Seeed-Studio/beaglebone-getting-started/Docs/images/bbgw-leds.jpg

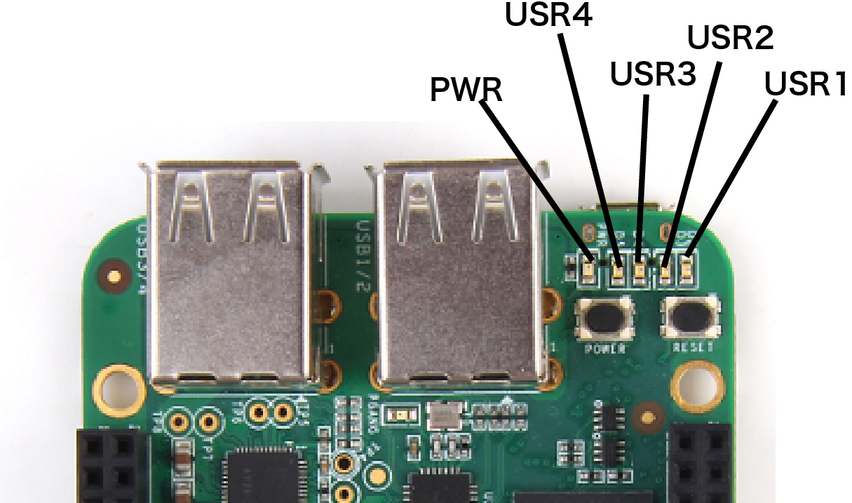
Docs/images/bbgw-leds.jpg
