Seeed-Studio/beaglebone-getting-started/Docs/images/BBGW-on-USB.png

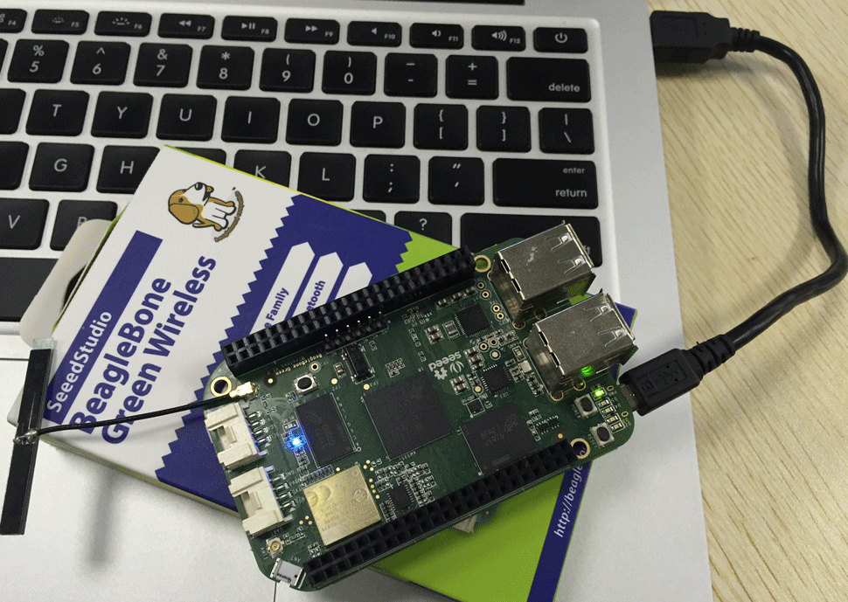
Docs/images/BBGW-on-USB.png
