Seeed-Studio/beaglebone-getting-started/Docs/Hardware/BeagleBone_Green_Wireless_V1.0_BOM.xlsx

Part No. | Part Name | Part Description | Reference | Quantity | Unit
301010000 | SMD RES 0R-5%-1/16W;0402 | YAGEO;RC0402JR-070RL | R5,R6,R7,R8,R19,R20,R27,R29,R30,R46,R47,R48,R49,R50,R51,R159,R160,R161,R162,R224,R231,R232,R234,R235 | 24 | PCS
301010010 | SMD RES 4.7K-5%-1/16W;0402 | YAGEO;RC0402JR-074K7L | R23,R24,R25,R26,R71,R72,R73,R74,R163,R164 | 10 | PCS
301010034 | SMD RES 33R-5%-1/16W;0402 | YAGEO;RC0402JR-0733RL | R18,R45,R167,R176,R177,R178,R179,R180,R181,R182,R183,R184,R185,R186,R187,R188,R198,R199,R200,R203,R204,R205,R206,R207,R208,R236,R237,R238,R239 | 29 | PCS
301010043 | SMD RES 1M-1%-1/16W;0402 | YAGEO;RC0402FR-071ML | R17 | 1 | PCS
301010047 | SMD RES 10K-1%-1/16W;0402 | YAGEO;RC0402FR-0710KL | R14,R54,R96,R98,R100,R101,R102,R103,R104,R105,R106,R107,R108,R109,R110,R111,R150,R151,R152,R153,R154,R155,R156,R157,R191,R192,R193,R194,R196,R221,R223,R225,R227 | 33 | PCS
301010054 | SMD RES 47K-1%-1/16W;0402 | YAGEO;RC0402FR-0747KL | R228 | 1 | PCS
301010203 | SMD RES 0R-1%-1/10W;0603 | YAGEO;AC0603FR-070RL | R168 | 1 | PCS
301010264 | SMD RES 0.1R-5%-1/8W;0805 | YAGEO;RL0805JR-070R1L | FB8 | 1 | PCS
301010442 | SMD RES 100R-1%-1/16W;0402 | YAGEO;RC0402FR-07100RL | R75 | 1 | PCS
301010456 | SMD RES 100K-1%-1/16W;0402 | YAGEO;RC0402FR-07100KL | R1,R56,R65,R66,R67,R68,R76,R77,R78,R79,R80,R82,R83,R84,R85,R86,R87,R88,R89,R94,R95,R165,R189,R190,R220 | 25 | PCS
301010489 | SMD RES;49.9R-1%-1/10W-0402 | Panasonic;ERJ-2RKF49R9X | R22 | 1 | PCS
301010494 | SMD RES;240R-1%-0402 | Panasonic;667-ERJ-2RKF2400X | R99 | 1 | PCS
301010518 | SMD RES 120K-1%-1/16W;0402 | RC0402FR-07120KL | R215 | 1 | PCS
301010567 | SMD RES 1.5K-1%-1/16W;0402 | Yageo;RC0402FR-071K5L | R3,R4,R12,R97,R197 | 5 | PCS
301010738 | SMD RES 15K-1/16W-1%;0402 |  | R222 | 1 | PCS
301010829 | SMD RES 680R-1%-1/16W;0402 | Yageo;RC0402FR-07680RL | R218,R219,R229,R230 | 4 | PCS
301011069 | SMD RES 240K-1/16W-1%;0402 | YAGEO;RC0402FR-07240KL | R214,R216 | 2 | PCS
301011070 | SMD RES 52.3K-1/16W-1%;0402 | YAGEO;RC0402FR-0752K3L | R217 | 1 | PCS
302010004 | SMD CAP Ceramic 100nF-16V-10%-X7R;0402 | YAGEO;CC0402KRX7R7BB104 | C3,C28,C29,C30,C31,C33,C36,C37,C38,C41,C42,C43,C44,C45,C46,C47,C48,C49,C50,C51,C52,C53,C54,C56,C57,C58,C59,C60,C61,C63,C64,C65,C66,C67,C68,C69,C70,C71,C72,C73,C74,C75,C76,C78,C79,C80,C81,C82,C83,C84,C85,C86,C87,C88,C92,C93,C94,C97,C98,C99,C100,C101,C102,C103,C105,C107,C108,C109,C110,C111,C112,C113,C114,C115,C116,C117,C119,C120,C121,C124,C127,C128,C129,C130,C152,C154,C155,C158,C159,C167,C173,C174,C175,C176,C181,C182,C185,C186,C187,C189,C191,C193,C195 | 103 | PCS
302010005 | SMD CAP Ceramic 1nF-50V-10%-X7R;0402 | YAGEO;CC0402KRX7R9BB102 | C32,C123 | 2 | PCS
302010012 | SMD CAP Ceramic 100pF-50V-5%-NPO;0402 | YAGEO;CC0402JRNPO9BN101 | C202,C203,C204,C205 | 4 | PCS
302010016 | SMD CAP Ceramic 18pF-50V-5%-NPO;0402 | YAGEO;CC0402JRNPO9BN180 | C21,C22,C25,C26,C183,C184 | 6 | PCS
302010040 | SMD CAP Ceramic 1uF-10V-10%-X5R;0402 | YAGEO;CC0402KRX5R6BB105 | C89,C90,C91,C104,C106,C199 | 6 | PCS
302010047 | SMD CAP Ceramic 10pF-50V-2%-NPO;0402 | Murata;GRM1555C1H100GA01D | C171,C172 | 2 | PCS
302010158 | SMD CAP Ceramic 10uF-10V-(-20%～+80%)-Y5V;0805 | YAGEO;CC0805ZKY5V6BB106 | C1,C2,C4,C7,C8,C9,C10,C11,C12,C13,C14,C15,C39,C40,C55,C62,C77,C95,C96,C118,C122,C126,C153,C168,C169,C170,C177,C180,C188,C197 | 30 | PCS
302010171 | SMD CAP Ceramic 22uF-6.3V-20%-X5R;0805 | YAGEO;CC0805MKX5R5BB226 | C178,C179 | 2 | PCS
302010233 | SMD CAP Ceramic 2.2uF-6.3V-20%-X5R;0402 | YAGEO;CC0402MRX5R5BB225 | C16,C18,C125,C24 | 4 | PCS
302010742 | SMD CAP Ceramic 100uF-6.3V-20%-X5R;1206 | YAGEO;CC1206MKX5R5BB107 | C190,C192,C194,C196,C198 | 5 | PCS
303010128 | SMD Inductor 2.2uH-20%-1.3A;2P-1008 | Murata;LQM2HPN2R2MG0L | L1,L2,L3 | 3 | PCS
303010172 | SMD Innductor 0.47uH-20%;L2.0*W1.6*H1.0mm | Sunlord;WPN201610MR47MT | L11 | 1 | PCS
303010342 | SMD Inductor 0.33uH-20%-0.024R-3.2A;2.0*1.6*1.0mm | Murata;LQM2MPNR33MGH | L12 | 1 | PCS
303010524 | SMD Inductor 5.6nH-0.3nH-300mA;0402 | Murata;LQG15HS5N6S02D | C200 | 1 | PCS
303030024 | SMD Ferrite Bead;120R-2A;0603 | BLM18PG121SN1D | L4,L13,L14,L15,L16,L17,L18,L19,L20 | 9 | PCS
303030029 | SMD Ferrite Bead;150R-800mA-0805 | Laird-Signal Integrity Products;LI0805H151R-10 | FB1,FB2,FB3 | 3 | PCS
304060074 | SMD Diode ESD 0.05pF;0402 | SURGE;ESDPSA0402V05 | D9,D10,D11,D12,D13,D14,D15,D16,D17,D18,D19,D20,D21,D22,D23,D24 | 16 | PCS
304090043 | SMD LED Clear-Green;LED-0603 | Everlight;19-217/G7C-AN1P2/3T(正贴) | D1,D6,D8 | 3 | PCS
304090045 | SMD LED Clear-Blue;0603 | Ever Light;19-217/BHC-ZL1M2RY/3T(正贴) | D2,D3,D4,D5,D7 | 5 | PCS
305030000 | SMD MOSFET N-CH 50V-200mA;SOT-323-3 | Diodes Inc;BSS138W-7-F | Q3,Q4 | 2 | PCS
305050004 | SMD Transistor Array 2 NPN-50V-100mA-SOT-363 | Diodes Incorporated;DDC114YU-7-F | Q1,Q2 | 2 | PCS
306010085 | SMD Crystal;32.768KHz-12.5pF-20PPM-50K-8*3.8*2.5mm;SOJ-4 | ABS25-32.768KHZ-T | Y1 | 1 | PCS
306010108 | SMD Crystal;24MHz-18pF-30ppm-2P-5*3.2*1.35 | TXC CORPORATION;7A-24.000MAAJ-T | Y2 | 1 | PCS
306010127 | SMD Crystal 12MHz-6pF-30ppm-150R;4P-L2.5*W2.0mm | Epson;FA-20H 12MHz | Y5 | 1 | PCS
306020013 | SMD Oscillator;24.576MHz-CMOS-4P-2.5*2*0.9mm | Abracon Corporation;ASDMB-24.576MHZ-LC-T | Y4 | 1 | PCS
306020041 | SMD Oscillator 32.768kHz;4P-L3.2*W2.5*H1.0mm | TXC;7XZ-32.768KHz | OSC1 | 1 | PCS
310010099 | SMD IC MCU;NFBGA-324（15x15） | TI;AM3358BZCZ100 | U5 | 1 | PCS
310030161 | SMD IC PMIC;DFN(2*2)-8 | ETA;ETA3410D2I-T | U19,U20 | 2 | PCS
310030209 | SMD IC PMIC;VQFN-48 | TI;TPS65217CRSLR | U2 | 1 | PCS
310050077 | SMD IC Logic;SC-70-5 | TI;SN74LVC1G06DCKR | U3 | 1 | PCS
310050078 | SMD IC Logic;US8(8-VFSOP | TI;SN74LVC2G241DCUR | U15 | 1 | PCS
310050079 | SMD IC Logic;SC-70-5 | TI;SN74LVC1G07DCKR | U16 | 1 | PCS
310050187 | SMD IC Logic;VQFN-20 | TI;TXS0108ERGYR | U21,U22 | 2 | PCS
310090051 | SMD IC Memory;SOT-23-5 | Microchip;24LC32AT-I/OT | U7 | 1 | PCS
310090304 | SMD IC Memory;TFBGA-96（8x14) | Micron;MT41K256M16TW-107:P | U12 | 1 | PCS
310090305 | SMD IC Memory;VFBGA-153 | Micron;MTFC4GACAJCN-1M WT | U13 | 1 | PCS
310990024 | SMD Precision Load Switch with Adjustable Curren IC;DFN22-6 | ETA;ETA6020D2G-T/U | U24 | 1 | PCS
310990129 | SMD USB 2.0 MTT Hub Controller;QFN-28 | Genesys Logic;GL852G-OHG | U23 | 1 | PCS
311020045 | SMD Button Top;Black-4P-L4.7*W3.5*H2.5 | 东奥;DHT-4325A | S1,S2,S3 | 3 | PCS
317990079 | SMD Combo Module;100P-13.3*13.4*2mm | JORJIN;WG7835-V0 | U18 | 1 | PCS
318010123 | SMD Built-in Antenna 2.4GHz;3P-5.2*3.7*0.7mm | Inpad;ACA-5036-A2-CC-S | ANT1 | 1 | PCS
319011441 | PCB;BeagleBone_Green_Wireless_V1.0-哑光绿油白字-6层 | 化学沉金-121.4*174.75*1.6mm-FR4;钢网;404010698 |  | 1 | PCS
320010000 | SMD Micro USB-B-without POST-W/P;5+4-0.65-L7.4*W5.0*H2.35mm | 山旗 | P4 | 1 | PCS
320020078 | DIP Black Male Header VERT;1*6P-2.54-2.54-11.6/3.0mm | 宇熙 | J1 | 1 | PCS
320030146 | DIP Black Female Header;2*23P-2.54*8.5-3.15mm | 宇熙 | P8,P9 | 2 | PCS
320090010 | SMD Micro SD Card Holder;8P-13.9*15mm | ALPS;SCHA5B0200 | P10 | 1 | PCS
320110032 | SMD Grove;4P-2.0-90D | 2.0-4P卧贴带锁座子 | J4,J5 | 2 | PCS
320110048 | SMD Female;U-FL Connector | I-PEX; | J6,J7 | 2 | PCS
320110409 | DIP USB FEMAL TYPE A;8P-2.0-90D;双层 | 商旗;ST-USB-201C | J8,J9 | 2 | PCS
327130913 | BeagleBoneGreen Wireless_流水号二维码贴纸 | 铜版不干胶贴纸-8*40mm |  | 1 | PCS
