Seeed-Studio/beaglebone-getting-started/Docs/Hardware/BeagleBone_Green_Wireless_V1.0_SCH&PCB/BeagleBone_Green_Wireless_V1.0_SCH.pdf

1
3

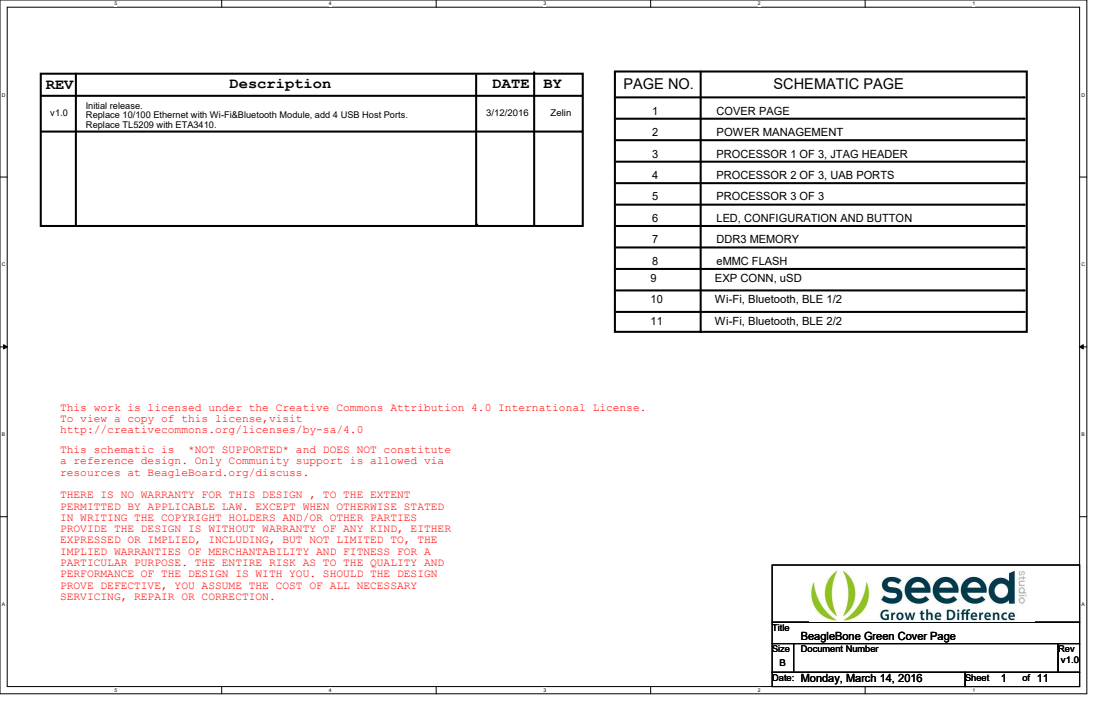
[picture p16: page 1]
eMMC FLASH; PAGE NO.; SCHEMATIC PAGE; REV; Description; DATE; Zelin; Title; Size Document Number; Rev; Date:; Sheet; BeagleBone Green Cover Page; Monday, March 14, 2016

Initial release.
Replace 10/100 Ethernet with Wi-Fi&Bluetooth Module, add 4 USB Host Ports.
Replace TL5209 with ETA3410.

COVER PAGE
POWER MANAGEMENT
PROCESSOR 1 OF 3, JTAG HEADER
PROCESSOR 2 OF 3, UAB PORTS
PROCESSOR 3 OF 3
LED, CONFIGURATION AND BUTTON
DDR3 MEMORY
EXP CONN, uSD
10 Wi-Fi, Bluetooth, BLE 1/2
11 Wi-Fi, Bluetooth, BLE 2/2

This work is licensed under the Creative Commons Attribution 4.0 International License.
To view a copy of this license,visit
http://creativecommons.org/licenses/by-sa/4.0
This schematic is *NOT SUPPORTED* and DOES NOT constitute
a reference design. Only Community support is allowed via
resources at BeagleBoard.org/discuss.
THERE IS NO WARRANTY FOR THIS DESIGN , TO THE EXTENT
PERMITTED BY APPLICABLE LAW. EXCEPT WHEN OTHERWISE STATED
IN WRITING THE COPYRIGHT HOLDERS AND/OR OTHER PARTIES
PROVIDE THE DESIGN IS WITHOUT WARRANTY OF ANY KIND, EITHER
EXPRESSED OR IMPLIED, INCLUDING, BUT NOT LIMITED TO, THE
IMPLIED WARRANTIES OF MERCHANTABILITY AND FITNESS FOR A
PARTICULAR PURPOSE. THE ENTIRE RISK AS TO THE QUALITY AND
PERFORMANCE OF THE DESIGN IS WITH YOU. SHOULD THE DESIGN
PROVE DEFECTIVE, YOU ASSUME THE COST OF ALL NECESSARY
SERVICING, REPAIR OR CORRECTION.

Title
BeagleBone Green Cover Page

# Battery access pins. Pins are randomly placed to fit

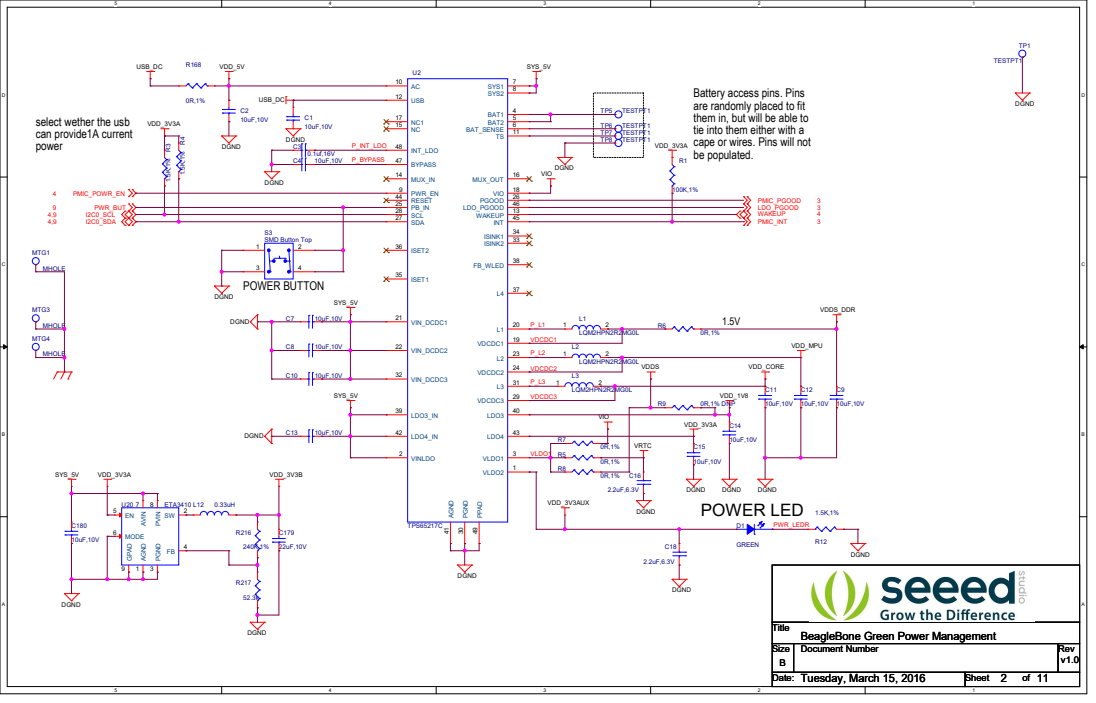
[picture p17: page 2]

select wether the usb
can provide1A current

them in, but will be able to
tie into them either with a
cape or wires. Pins will not
VDD_3V3A
be populated.

# RESET

3.3V

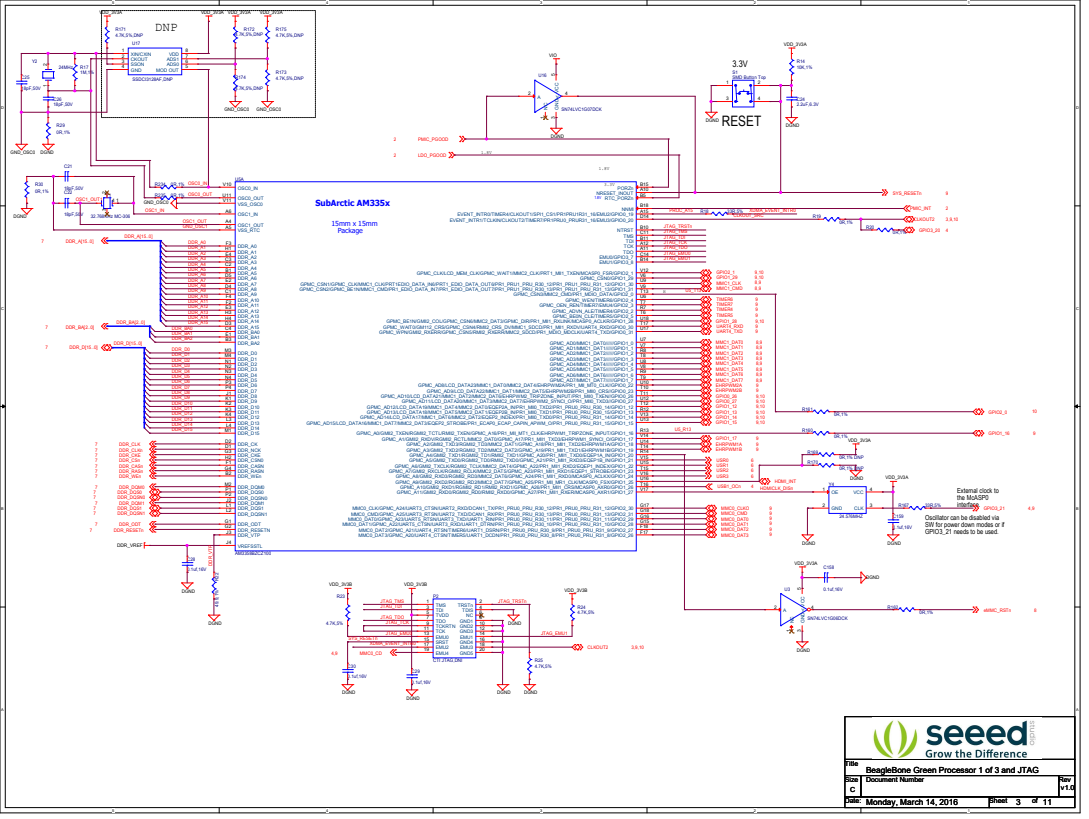
[picture p18: page 3]

PORZn B15 NRESET_INOUT A10 NNMI B18 EVENT_INTR0/TIMER4/CLKOUT1/SPI1_CS1/PR1PRU1R31_16/EMU2/GPIO0_19 A15 EVENT_INTR1/TCLKIN/CLKOUT2/TIMER7/PR1PRU0_PRUR31_16/EMU3/GPIO0_20 D14 TMS C11 NTRST B10 TCK A12 TDI B11 TDO A11 EMU0/GPIO3_7 C14 DDR_A0 F3 DDR_A1 H1 DDR_A2 E4 DDR_A3 C3 DDR_A4 C2 DDR_A5 B1 DDR_A6 D5 DDR_A7 E2 DDR_A8 D4 DDR_A9 C1 DDR_A10 F4 DDR_A11 F2 DDR_A12 E3 DDR_A13 H3 DDR_A14 H4 DDR_D0 M3 DDR_D1 M4 DDR_D2 N1 DDR_D3 N2 DDR_D4 N3 DDR_D5 N4 DDR_D6 P3 DDR_D7 P4 DDR_D8 J1 DDR_D9 K1 DDR_D10 K2 DDR_D11 K3 DDR_D12 K4 DDR_D13 L3 DDR_D14 L4 DDR_D15 M1 DDR_CK D2 DDR_NCK D1 DDR_CSN0 H2 DDR_CASN F1 DDR_RASN G4 DDR_WEn B2 DDR_BA0 C4 DDR_BA1 E1 DDR_BA2 B3 DDR_DQM0 M2 DDR_DQS0 P1 DDR_DQSN0 P2 DDR_DQM1 J2 DDR_DQS1 L1 DDR_DQSN1 L2 DDR_ODT G1

Oscillator can be disabled via
SW for power down modes or if
GPIO3_21 needs to be used.

# VDD_ADC GNDA_ADC

# VDD_3V3B DGND

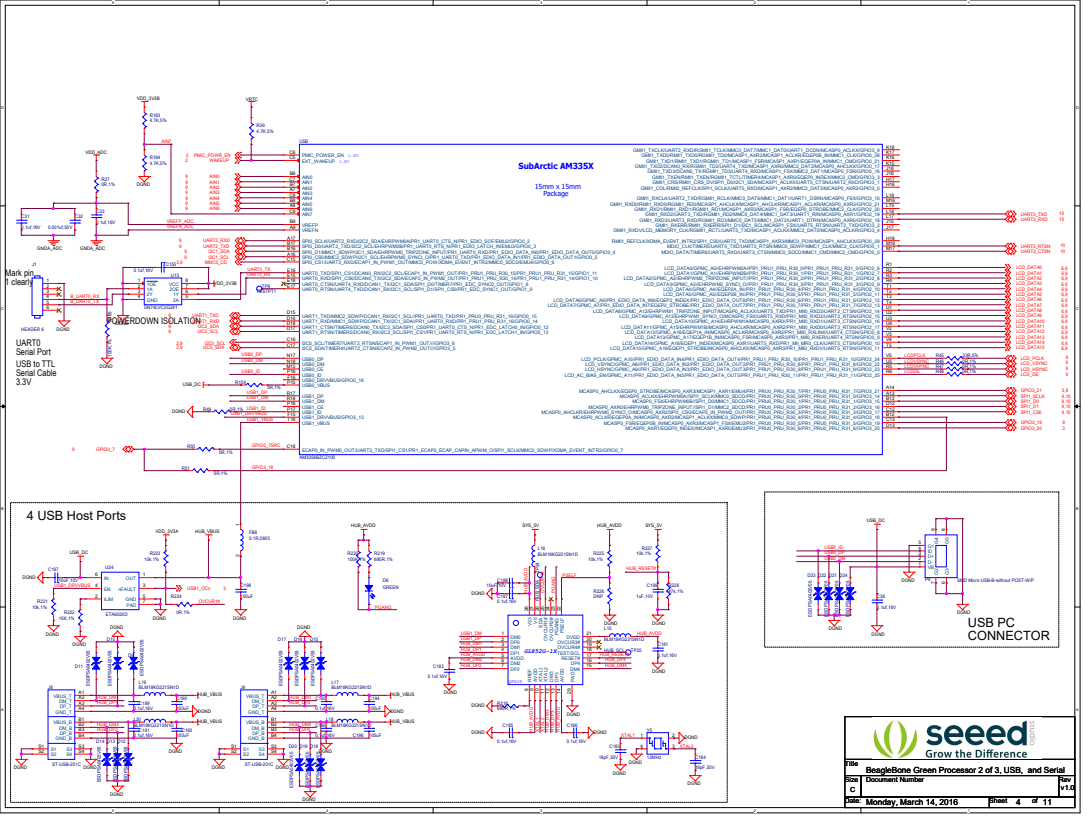
[picture p19: page 4]

9 XTAL1 10 XTAL2 11 DM3 12 DP3 13 AVDD 14 V33 28 V5 27 SDA 26 OVCUR1# 25 OVCUR2# 24 PGANG 23 PSELF 22 PAD 29

# C460.1uf,16V C96

# 0.1uf,16V C83

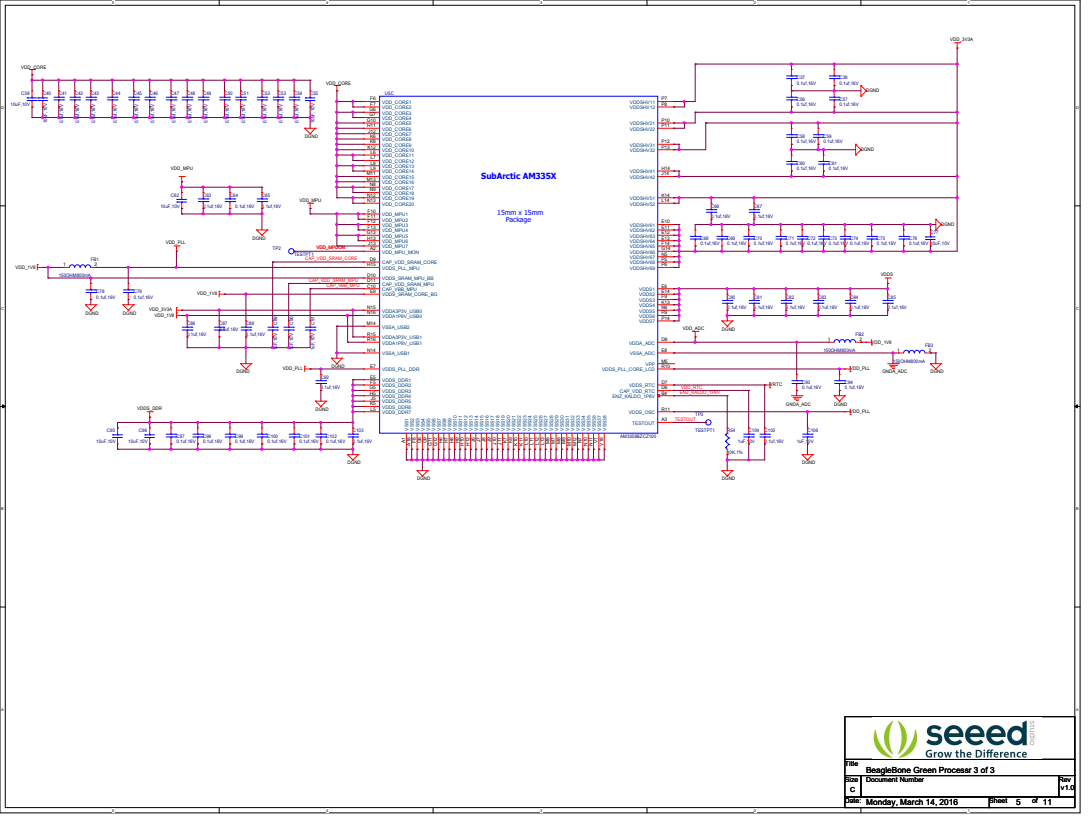
[picture p20: page 5]

## SYS_BOOT10

## SYS_BOOT4

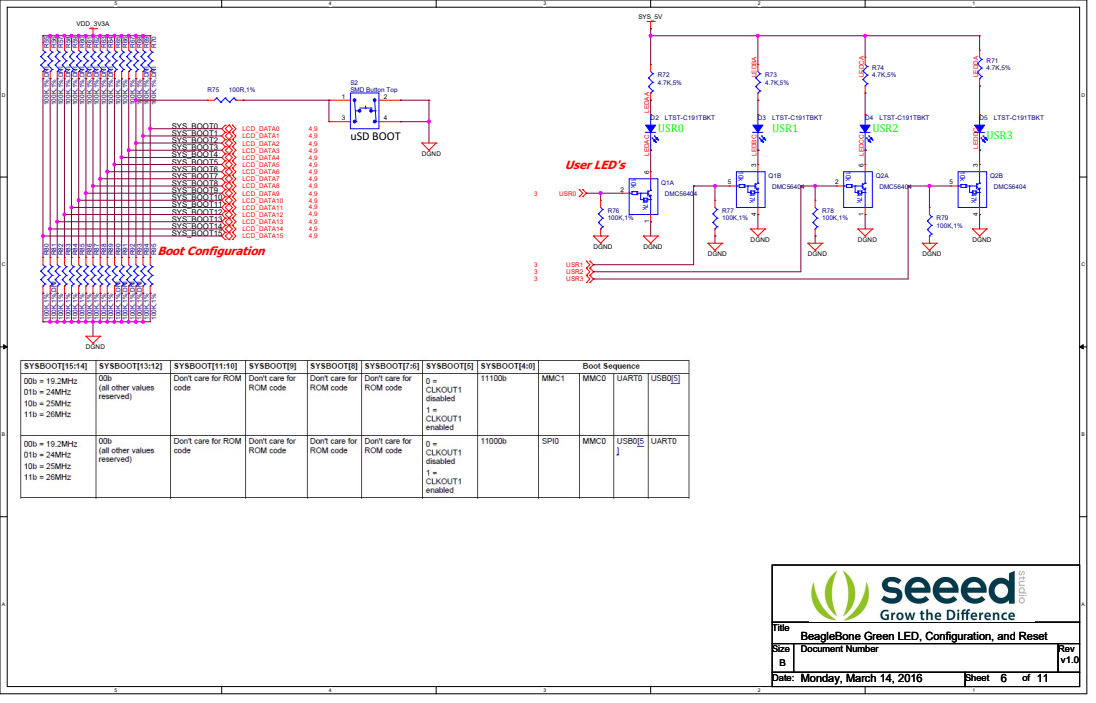
[picture p21: page 6]

SYS_BOOT5
SYS_BOOT6
SYS_BOOT7
SYS_BOOT8
SYS_BOOT9
SYS_BOOT11
SYS_BOOT12
SYS_BOOT13
SYS_BOOT14

Title
BeagleBone Green LED, Configuration, and Reset

# DDR3L SDRAM

## DGND

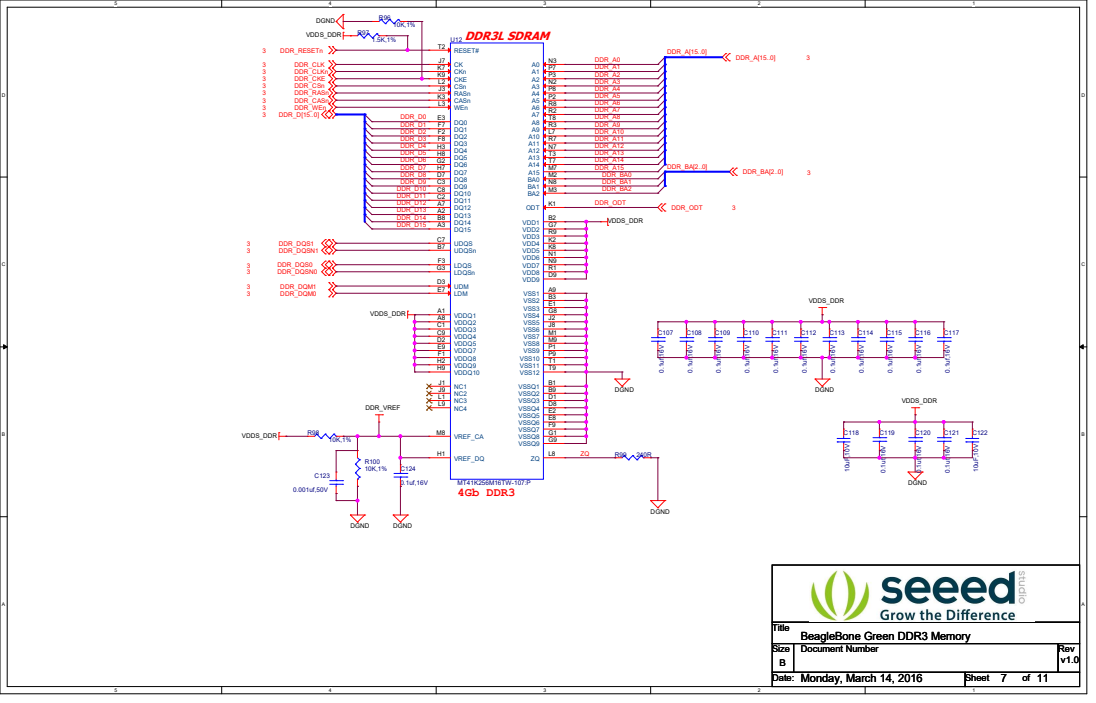
[picture p22: page 7]

## DGND DGND

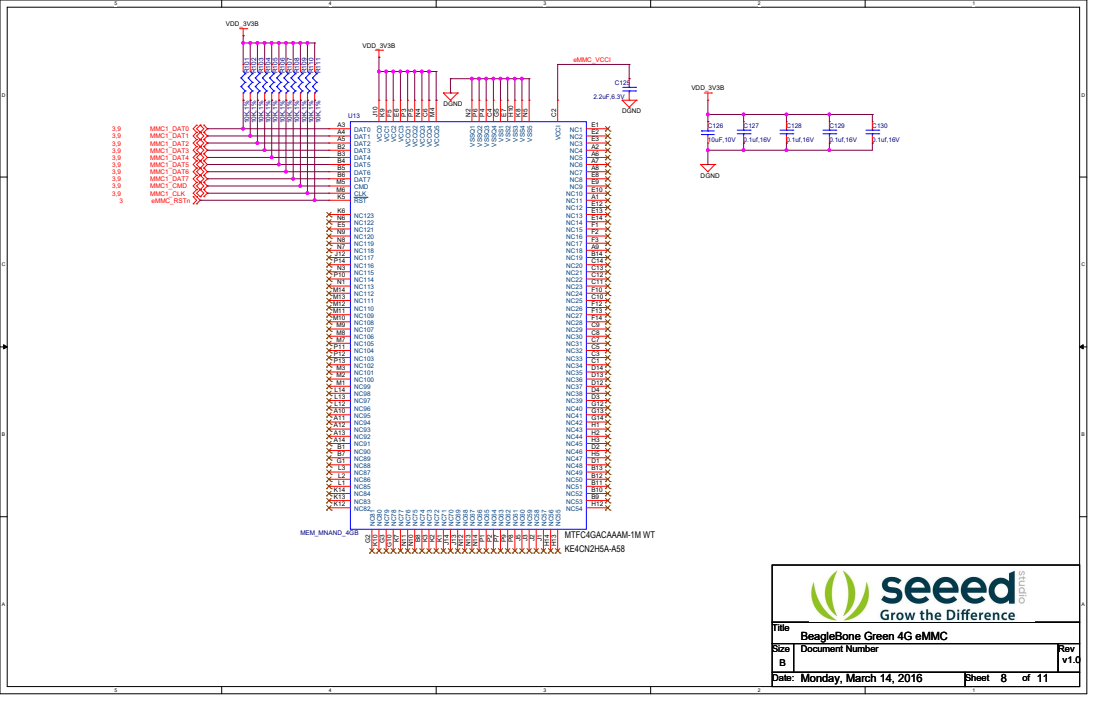
[picture p23: page 8]

uSD CONNECTOR CAUTION: USED ON BOARD | CAUTION: USED ON BOARD

## DGND

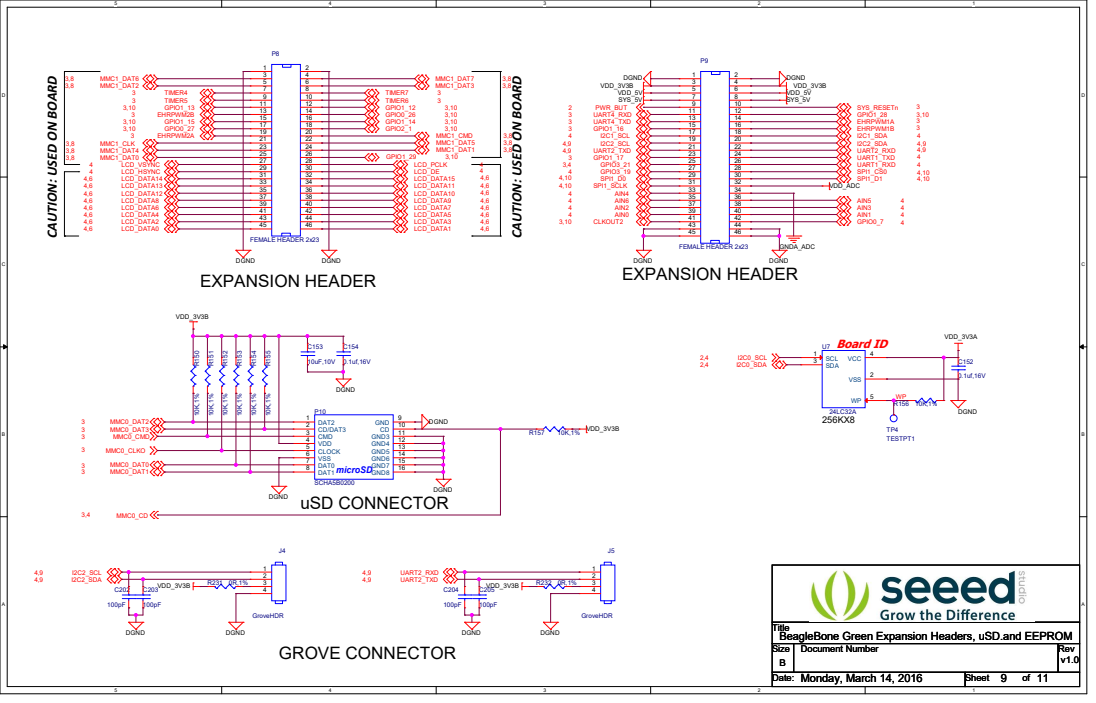
[picture p24: page 9]

Title
BeagleBone Green Expansion Headers, uSD.and EEPROM

## I2S_WCLK_OUT <--> SPI1_D0 I2S_BCLK_OUT <--> SPI1_SCLK

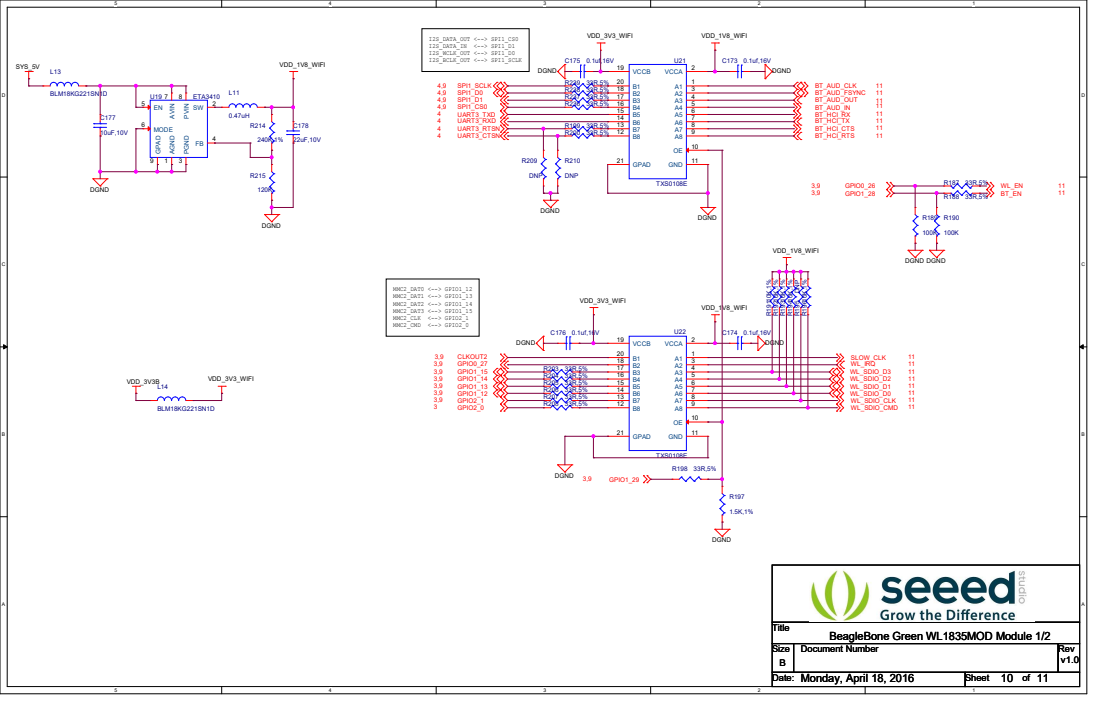
[picture p25: page 10]

### DGND

### DGND

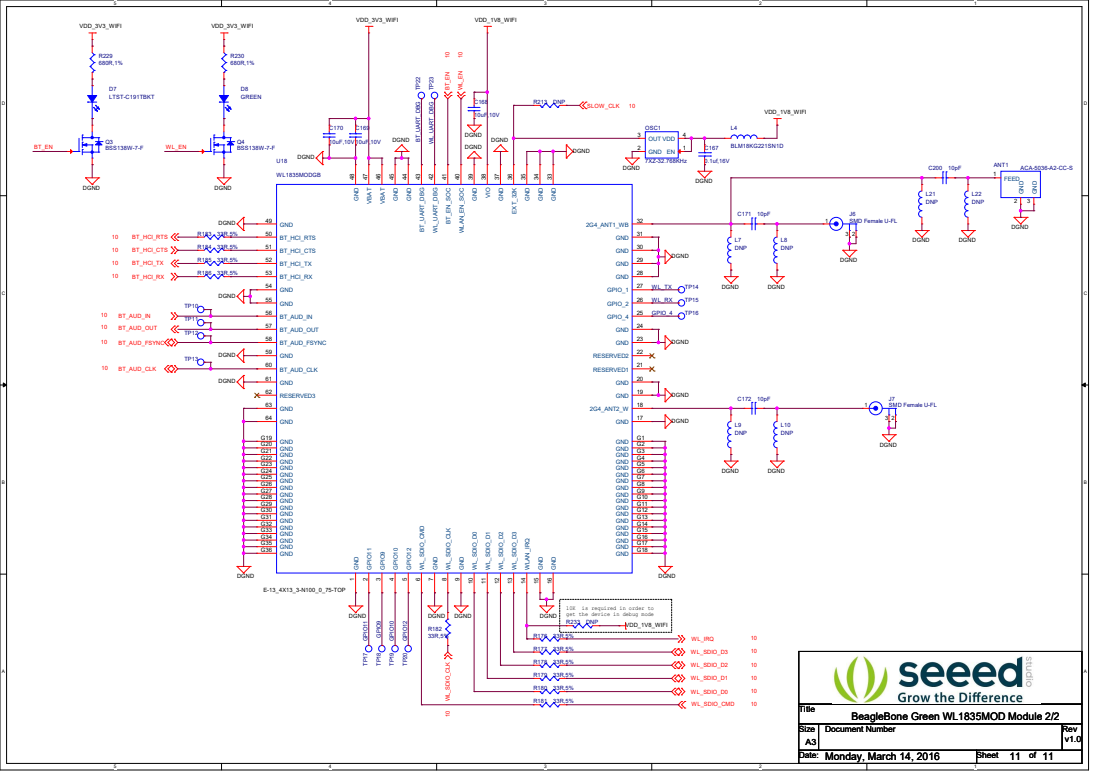
[picture p26: page 11]

6 BT_HCI_RTS 50 BT_HCI_RX 53 BT_HCI_TX 52 BT_HCI_CTS 51 GND 16 GPIO_4 25 GPIO_2 26 GPIO_1 27 BT_EN_SOC 41 WLAN_IRQ 14 WLAN_EN_SOC 40 BT_UART_DBG 43 WL_UART_DBG 42 GND G13 GND G14 GND G15 GND G16 GND G9 GND G10 GND 48

GND G36
get the device in debug mode DGND

A A 10K is required in order to
