Seeed-Studio/beaglebone-getting-started/(list of files, drawings)

Other design files:
Docs/Hardware/BeagleBone_Green_Wireless_V1.0_SCH&PCB/BeagleBone_Green_Wireless_V1.0.DSN
