Seeed-Studio/beaglebone-getting-started/(commit log)

2016-04-20 add Beaglebone Green doc and photo
    [BEAGLEBONE_GREEN_V1.DSN, BONE_BOM.xls, BeagleBone Green v1_Ebom.xlsx]
2016-05-07 update to BBGW
    [BEAGLEBONE_GREEN_V1.DSN, BeagleBone Green v1_Ebom.xlsx, BeagleBone_Green_Wireless_V1.0.DSN, BeagleBone_Green_Wireless_V1.0_BOM.xlsx]
2017-01-26 Drivers: Windows 10 (1607) and MacOS X 10.10
